Elemecca/hp8565/readout/bracket.FCStd

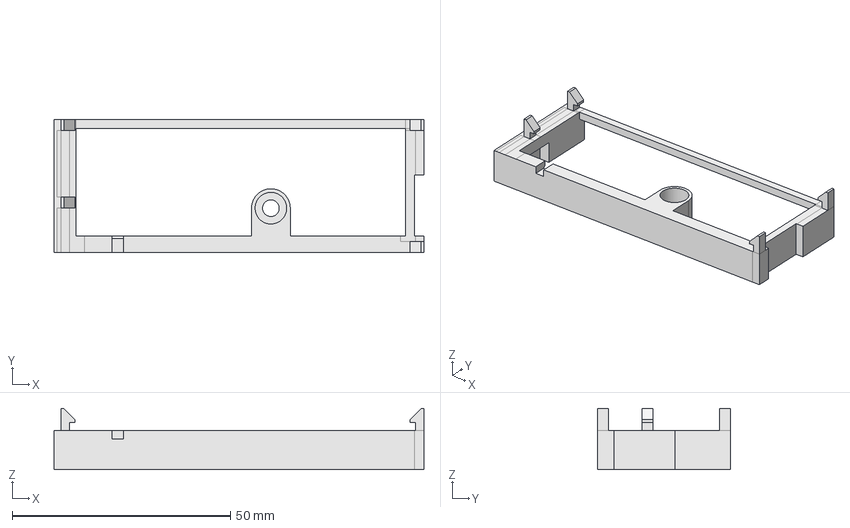
[picture p1: CAD file, 2023-08-11]
readout/bracket.FCStd
84.7 x 30.5 x 14.0 mm
