Elemecca/hp8565/readout/board/hp8565-readout/hp8565-readout.kicad_pcb

## KiCad design readout/board/hp8565-readout/hp8565-readout.kicad_pcb (2023-07-09)

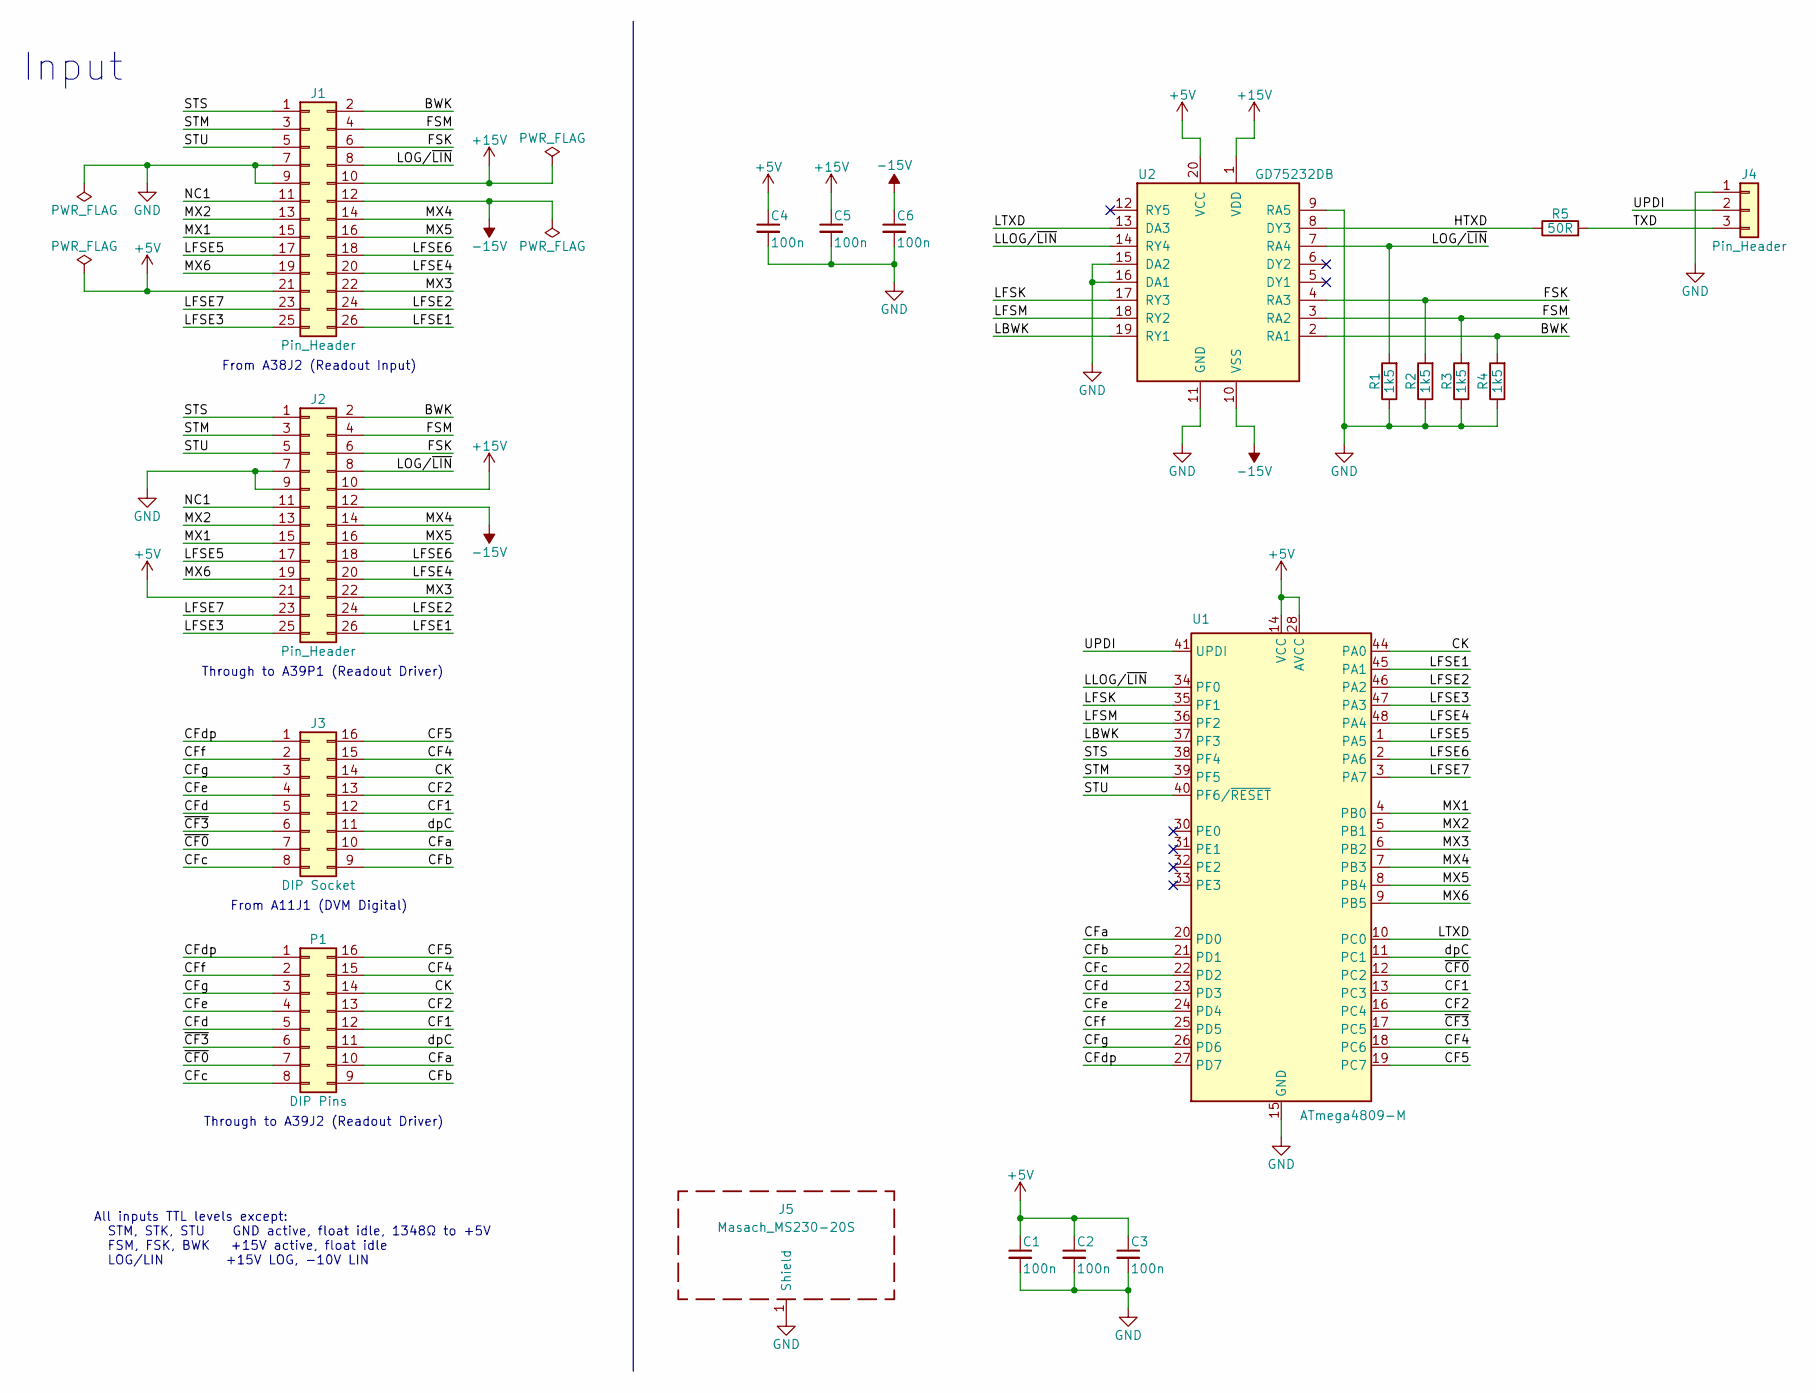
[picture p2: schematic hp8565-readout.kicad_sch, HP8565A Front Panel to Serial]

Parts:
C1, C2, C3, C4, C5, C6: 100n; C_0402_1005Metric
J1, J2: Pin_Header; PinHeader_2x13_P2.54mm_Vertical
J3: DIP Socket; DIP-16_W7.62mm_Socket
J4: Pin_Header; PinHeader_1x03_P2.54mm_Horizontal
J5: Masach_MS230-20S; Masach_MS230-20
P1: DIP Pins; DIP-16_W7.62mm
R1, R2, R3, R4: 1k5; R_0402_1005Metric
R5: 50R; R_0402_1005Metric
U1: ATmega4809-M; UQFN-48-1EP_6x6mm_P0.4mm_EP4.62x4.62mm
U2: GD75232DB; SSOP-20_4.4x6.5mm_P0.65mm

Connections:
+5V: C1.1, C2.1, C3.1, C4.1, J1.21, J2.21, U1.14 (VCC), U1.28 (AVCC), U1.42 (VCC), U2.20 (VCC)
+15V: C5.1, J1.10, J2.10, U2.1 (VDD)
-15V: C6.1, J1.12, J2.12, U2.10 (VSS)
/BWK: J1.2, J2.2, R4.2, U2.2 (RA1)
/CF1: J3.12, P1.12, U1.13 (PC3)
/CF2: J3.13, P1.13, U1.16 (PC4)
/CF4: J3.15, P1.15, U1.18 (PC6)
/CF5: J3.16, P1.16, U1.19 (PC7)
/CFa: J3.10, P1.10, U1.20 (PD0)
/CFb: J3.9, P1.9, U1.21 (PD1)
/CFc: J3.8, P1.8, U1.22 (PD2)
/CFd: J3.5, P1.5, U1.23 (PD3)
/CFdp: J3.1, P1.1, U1.27 (PD7)
/CFe: J3.4, P1.4, U1.24 (PD4)
/CFf: J3.2, P1.2, U1.25 (PD5)
/CFg: J3.3, P1.3, U1.26 (PD6)
/CK: J3.14, P1.14, U1.44 (PA0)
/FSK: J1.6, J2.6, R2.2, U2.4 (RA3)
/FSM: J1.4, J2.4, R3.2, U2.3 (RA2)
/HTXD: R5.1, U2.8 (DY3)
/LBWK: U1.37 (PF3), U2.19 (RY1)
/LFSE1: J1.26, J2.26, U1.45 (PA1)
/LFSE2: J1.24, J2.24, U1.46 (PA2)
/LFSE3: J1.25, J2.25, U1.47 (PA3)
/LFSE4: J1.20, J2.20, U1.48 (PA4)
/LFSE5: J1.17, J2.17, U1.1 (PA5)
/LFSE6: J1.18, J2.18, U1.2 (PA6)
/LFSE7: J1.23, J2.23, U1.3 (PA7)
/LFSK: U1.35 (PF1), U2.17 (RY3)
/LFSM: U1.36 (PF2), U2.18 (RY2)
/LLOG/~LIN: U1.34 (PF0), U2.14 (RY4)
/LOG/~LIN: J1.8, J2.8, R1.2, U2.7 (RA4)
/LTXD: U1.10 (PC0), U2.13 (DA3)
/MX1: J1.15, J2.15, U1.4 (PB0)
/MX2: J1.13, J2.13, U1.5 (PB1)
/MX3: J1.22, J2.22, U1.6 (PB2)
/MX4: J1.14, J2.14, U1.7 (PB3)
/MX5: J1.16, J2.16, U1.8 (PB4)
/MX6: J1.19, J2.19, U1.9 (PB5)
/NC1: J1.11, J2.11
/STM: J1.3, J2.3, U1.39 (PF5)
/STS: J1.1, J2.1, U1.38 (PF4)
/STU: J1.5, J2.5, U1.40 (PF6/~RESET)
/TXD: J4.3, R5.2
/UPDI: J4.2, U1.41 (UPDI)
/dpC: J3.11, P1.11, U1.11 (PC1)
/~CF0: J3.7, P1.7, U1.12 (PC2)
/~CF3: J3.6, P1.6, U1.17 (PC5)
GND: C1.2, C2.2, C3.2, C4.2, C5.2, C6.2, J1.7, J1.9, J2.7, J2.9, J4.1, J5.1 (Shield), R1.1, R2.1, R3.1, R4.1, U1.15 (GND), U1.29 (GND), U1.43 (GND), U1.49 (GND), U2.9 (RA5), U2.11 (GND), U2.15 (DA2), U2.16 (DA1)

Notes on the sheet:
From A38J2 (Readout Input)
From A11J1 (DVM Digital)
Through to A39J2 (Readout Driver)
Input
Through to A39P1 (Readout Driver)
All inputs TTL levels except: STM, STK, STU GND active, float idle, 1348Ω to +5V FSM, FSK, BWK +15V active, float idle LOG/LIN +15V LOG, -10V LIN

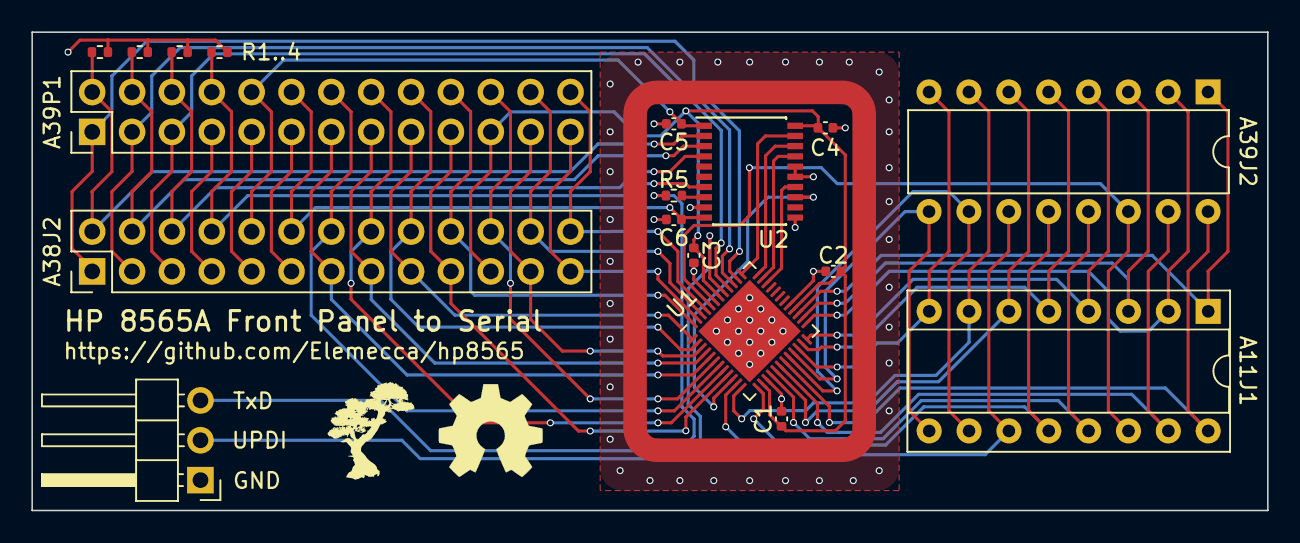
[picture p3: board hp8565-readout.kicad_pcb from above]

Board: 4 copper layers, 78.7 x 30.5 mm, 19 parts (0 on the bottom side), 49 nets.
