Elemecca/hp8565/(commit log)

2023-07-07 Start on readount board.
    [hp8565-readout.kicad_pcb, hp8565-readout.kicad_sch]
2023-07-08 Route CF connector.
    [hp8565-readout.kicad_pcb, hp8565-readout.kicad_sch]
2023-07-08 Clean up silkscreen and stuff.
    [hp8565-readout.kicad_pcb, hp8565-readout.kicad_sch]
2023-07-09 Set up for production exports.
    [hp8565-readout.kicad_pcb]
2023-08-10 First draft of mounting bracket.
    [bracket.FCStd]
2023-08-11 Second iteration of bracket.
    [bracket.FCStd]
2023-08-11 Working bracket.
    [bracket.FCStd]
