Elemecca/hp8565/(notices)

Notices in the files:
readout/board/hp8565-readout/hp8565-readout.kicad_pcb:
© 2023 Sam Hanes, licensed under CERN-OHL-P v2
